pascalguttmann/fsd-amp/README.md

# fsd-amp

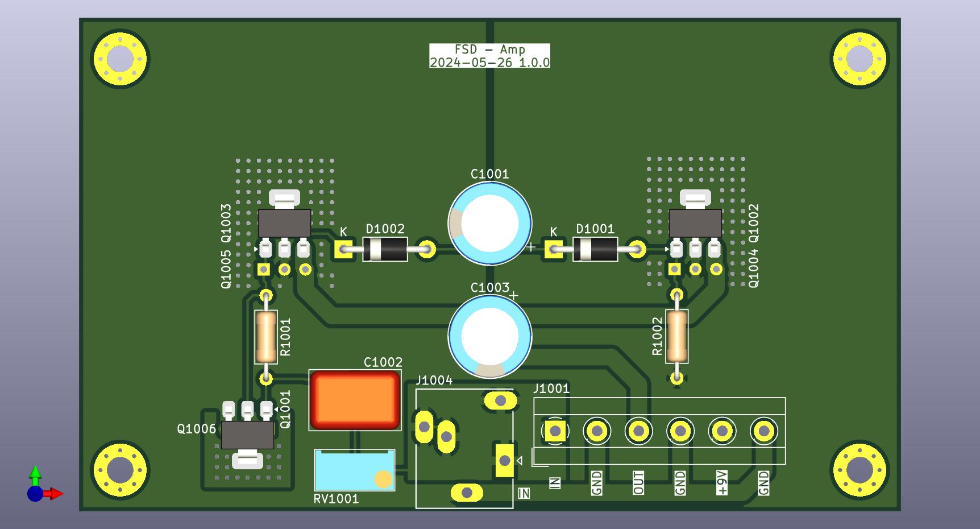
[picture p1: 3d-preview/fsd-amp.jpg]


Linear Audio Amplifier as demonstration for workshop at Freie Schule Dreisamtal.
PCB is used as a demonstrator for soldering excercises and fundamentals of circuit design.
