pascalguttmann/fsd-amp/bom/orders.xlsx

Sheet: 240527_order
n | 15
# | Qty / n | Total Qty | VPN | VLNK | Ordered
1 | 2 | 30 | RAD 470/16 | https://www.reichelt.de/elko-radial-470-f-16-v-rm-5-0-85-c-2000h-20--rad-470-16-p15148.html?trstct=pol_0&nbc=1 | x
2 | 1 | 15 | MKS2-50 10µ | https://www.reichelt.de/mks2-pet-kondensator-10-f-5-50-vdc-rm-5-mks2-50-10--p172683.html?trstct=pos_11&nbc=1 | x
3 | 2 | 30 | 1N 4001 | https://www.reichelt.de/gleichrichterdiode-50-v-1-a-do-41-1n-4001-p1723.html?&trstct=pos_0&nbc=1 | x
4 | 1 | 15 | AKL 101-06 | https://www.reichelt.de/anschlussklemme-6-pol-2-mm-rm-5-08-akl-101-06-p36609.html?search=AKL+101-06 | x
5 | 1 | 15 | EBS 35 | https://www.reichelt.de/klinkeneinbaubuchse-3-5-mm-stereo-ebs-35-p7301.html?&trstct=pol_4&nbc=1 | x
6 | 2 | 30 | FZT 653 ZET | https://www.reichelt.de/bipolartransistor-npn-100-v-2-a-2-w-sot-223-fzt-653-zet-p219138.html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 | x
7 | 1 | 15 | FZT 753 ZET | https://www.reichelt.de/bipolartransistor-pnp-100-v-2-a-2-w-sot-223-fzt-753-zet-p216608.html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 | x
8 | 3 | 45
9 | 1 | 15 | METALL 47,0K | https://www.reichelt.de/widerstand-metallschicht-47-0-kohm-0207-0-6-w-1--metall-47-0k-p11823.html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 | x
10 | 1 | 15 | METALL 150 | https://www.reichelt.de/widerstand-metallschicht-150-ohm-0207-0-6-w-1--metall-150-p11527.html | x
11 | 1 | 15 | 64W-20K | https://www.reichelt.de/praezisionspotentiometer-25-gaenge-stehend-20-kohm-64w-20k-p2705.html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 | x
12 | 1 | 15 | HDS LPAC010-005 |  | x

Sheet: fsd-amp_1 0 0
# | Reference | Value | VPN | Qty | VLNK | MPN | Do Not Place | Exclude from BOM | Exclude from Board | Exclude from Simulation | Footprint | Datasheet | Description
1 | C1001,C1003 | 470u | RAD 470/16 | 2 | https://www.reichelt.de/elko-radial-470-f-16-v-rm-5-0-85-c-2000h-20--rad-470-16-p15148.html?trstct=pol_0&nbc=1 |  |  |  |  |  | fp:CP_Radial_D10.0mm_P5.00mm | https://www.reichelt.de/elko-radial-470-f-16-v-rm-5-0-85-c-2000h-20--rad-470-16-p15148.html?trstct=pol_0&nbc=1 | Polarized capacitor
2 | C1002 | 10u | MKS2-50 10µ | 1 | https://www.reichelt.de/mks2-pet-kondensator-10-f-5-50-vdc-rm-5-mks2-50-10--p172683.html?trstct=pos_11&nbc=1 |  |  |  |  |  | fp:C_Rect_L7.2mm_W11.0mm_P5.00mm_FKS2_FKP2_MKS2_MKP2 | https://cdn-reichelt.de/documents/datenblatt/B300/WIMA_MKS_2.pdf | Unpolarized capacitor
3 | D1001,D1002 | 1N4001 | 1N 4001 | 2 | https://www.reichelt.de/gleichrichterdiode-50-v-1-a-do-41-1n-4001-p1723.html?&trstct=pos_0&nbc=1 |  |  |  |  |  | fp:D_DO-41_SOD81_P10.16mm_Horizontal | https://cdn-reichelt.de/documents/datenblatt/A400/1N4001-1N4007_LUNSURE.pdf | Diode
4 | J1001 | Screw_Terminal_01x06 | AKL 101-06 | 1 | https://www.reichelt.de/anschlussklemme-6-pol-2-mm-rm-5-08-akl-101-06-p36609.html?search=AKL+101-06 |  |  |  |  | Excluded from simulation | fp:TerminalBlock_MetzConnect_Type101_RT01606HBWC_1x06_P5.08mm_Horizontal | https://cdn-reichelt.de/documents/datenblatt/C100/AKL101%23RIA.pdf | Generic screw terminal, single row, 01x06, script generated (kicad-library-utils/schlib/autogen/connector/)
5 | J1004 | AudioJack2_Ground_Switch | EBS 35 | 1 | https://www.reichelt.de/klinkeneinbaubuchse-3-5-mm-stereo-ebs-35-p7301.html?&trstct=pol_4&nbc=1 |  |  |  |  | Excluded from simulation | fp:Jack_3.5mm_Ledino_KB3SPRS_Horizontal | https://cdn-reichelt.de/documents/datenblatt/C160/KB3SPRS.pdf | Audio Jack, 2 Poles (Mono / TS), Grounded Sleeve, Switched Pole (Normalling)
6 | Q1001,Q1002 | FZT 653 ZET | FZT 653 ZET | 2 | https://www.reichelt.de/bipolartransistor-npn-100-v-2-a-2-w-sot-223-fzt-653-zet-p219138.html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 |  |  |  |  |  | fp:SOT-223-3_TabPin2 | https://cdn-reichelt.de/documents/datenblatt/A100/FZT653.pdf | NPN transistor, base/collector/emitter
7 | Q1003 | FZT 753 ZET | FZT 753 ZET | 1 | https://www.reichelt.de/bipolartransistor-pnp-100-v-2-a-2-w-sot-223-fzt-753-zet-p216608.html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 |  |  |  |  |  | fp:SOT-223-3_TabPin2 | https://cdn-reichelt.de/documents/datenblatt/A100/FZT753.pdf | PNP transistor, base/collector/emitter
8 | Q1004,Q1005,Q1006 | -- mixed values -- |  | 3 |  |  | DNP |  |  | Excluded from simulation | fp:TO-92_Inline_Wide_NOcourtyard | ~ | -- mixed values --
9 | R1001 | 47k | METALL 47,0K | 1 | https://www.reichelt.de/widerstand-metallschicht-47-0-kohm-0207-0-6-w-1--metall-47-0k-p11823.html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 |  |  |  |  |  | fp:R_Axial_DIN0207_L6.3mm_D2.5mm_P10.16mm_Horizontal | https://cdn-reichelt.de/documents/datenblatt/B400/METALL%23YAG.pdf | Resistor
10 | R1002 | 150 | METALL 150 | 1 | https://www.reichelt.de/widerstand-metallschicht-150-ohm-0207-0-6-w-1--metall-150-p11527.html |  |  |  |  |  | fp:R_Axial_DIN0207_L6.3mm_D2.5mm_P10.16mm_Horizontal | https://cdn-reichelt.de/documents/datenblatt/B400/METALL%23YAG.pdf | Resistor
11 | RV1001 | 20k | 64W-20K | 1 | https://www.reichelt.de/praezisionspotentiometer-25-gaenge-stehend-20-kohm-64w-20k-p2705.html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 |  |  |  |  |  | fp:Potentiometer_Bourns_3296W_Vertical | https://www.reichelt.de/praezisionspotentiometer-25-gaenge-stehend-20-kohm-64w-20k-p2705.html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 | Potentiometer
