pascalguttmann/fsd-amp/pdf/240609_fsd-amp_schematic_1.0.1.pdf

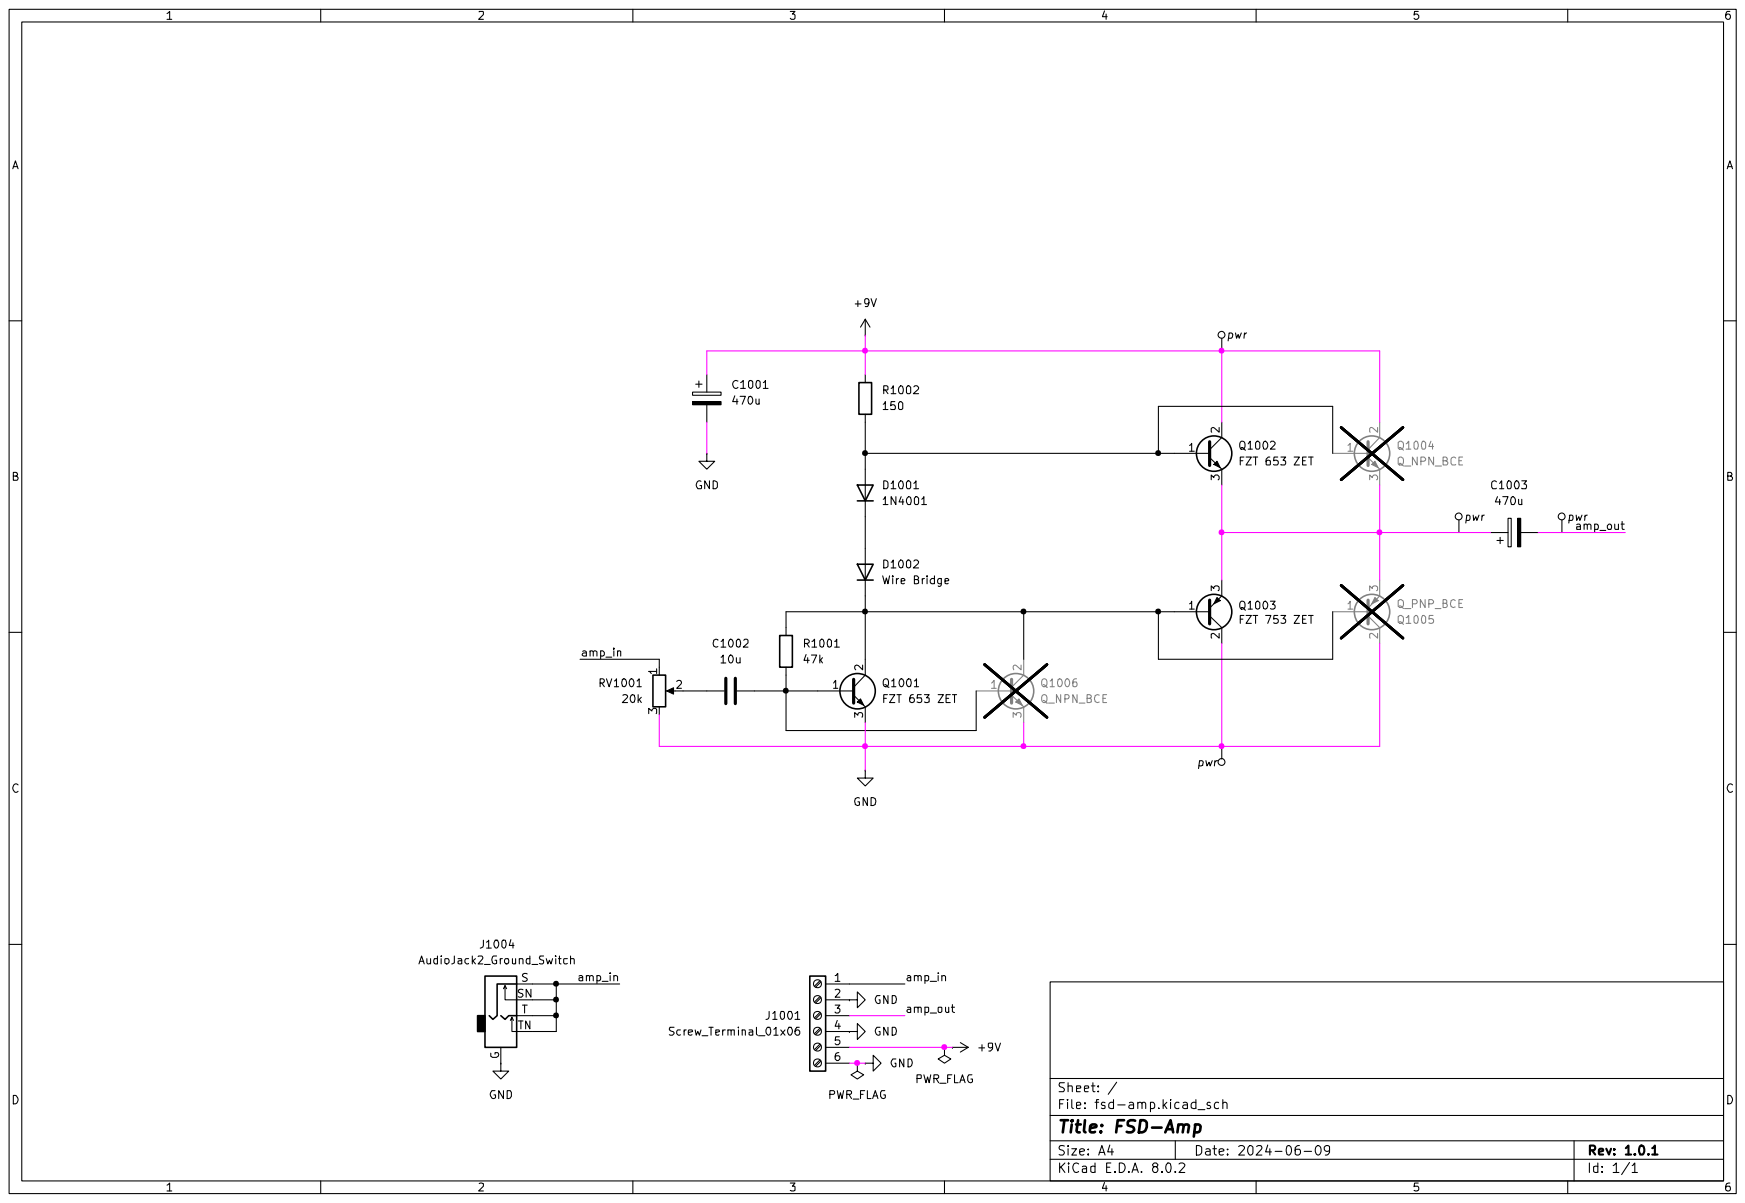
[picture p2: page 1]
