pascalguttmann/fsd-amp/fsd-amp.kicad_pcb

## KiCad design fsd-amp.kicad_pcb (2024-06-08)

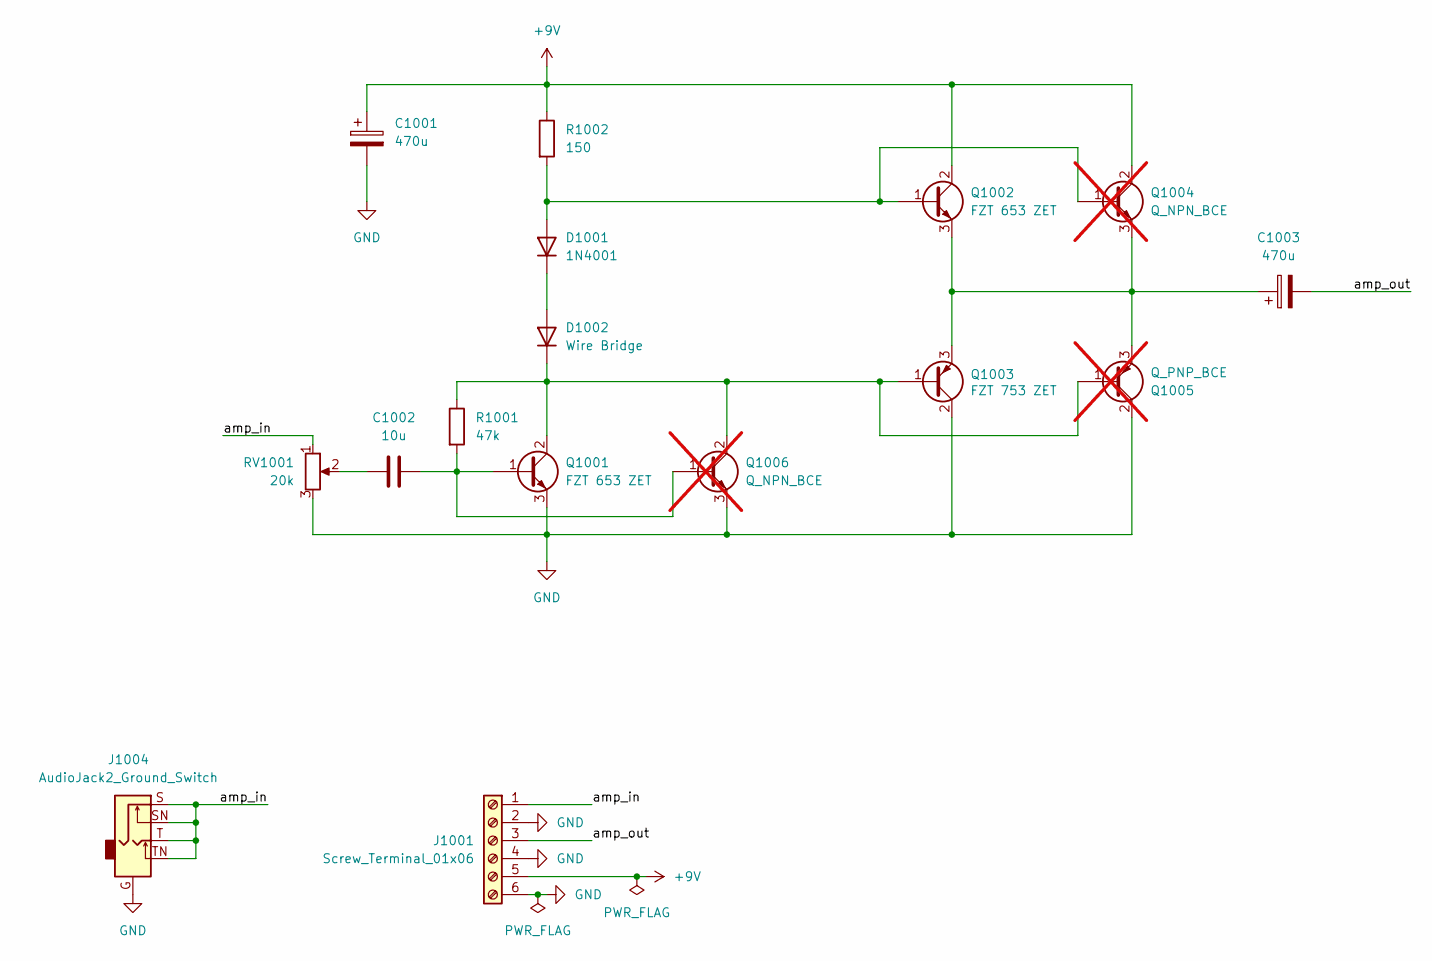
[picture p3: schematic fsd-amp.kicad_sch]

Parts:
C1001, C1003: 470u; CP_Radial_D10.0mm_P5.00mm
C1002: 10u; C_Rect_L7.2mm_W11.0mm_P5.00mm_FKS2_FKP2_MKS2_MKP2
D1001: 1N4001; D_DO-41_SOD81_P10.16mm_Horizontal
D1002: Wire Bridge; D_DO-41_SOD81_P10.16mm_Horizontal
J1001: Screw_Terminal_01x06; TerminalBlock_MetzConnect_Type101_RT01606HBWC_1x06_P5.08mm_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
J1004: AudioJack2_Ground_Switch; Jack_3.5mm_Ledino_KB3SPRS_Horizontal
Q1001, Q1002: FZT 653 ZET; SOT-223-3_TabPin2
Q1003: FZT 753 ZET; SOT-223-3_TabPin2
Q1004, Q1006: Q_NPN_BCE; TO-92_Inline_Wide_NOcourtyard; not fitted
Q1005: Q_PNP_BCE; TO-92_Inline_Wide_NOcourtyard; not fitted
R1001: 47k; R_Axial_DIN0207_L6.3mm_D2.5mm_P10.16mm_Horizontal
R1002: 150; R_Axial_DIN0207_L6.3mm_D2.5mm_P10.16mm_Horizontal
RV1001: 20k; Potentiometer_Bourns_3296W_Vertical

Connections:
+9V: C1001.1, J1001.5, Q1002.2 (C), Q1004.2 (C), R1002.1
/amp_in: J1001.1, J1004.S, J1004.SN, J1004.T, J1004.TN, RV1001.1
/amp_out: C1003.2, J1001.3
GND: C1001.2, J1001.2, J1001.4, J1001.6, J1004.G, Q1001.3 (E), Q1003.2 (C), Q1005.2 (C), Q1006.3 (E), RV1001.3
unnamed: C1002.1, RV1001.2
unnamed: D1001.2 (A), Q1002.1 (B), Q1004.1 (B), R1002.2
unnamed: D1001.1 (K), D1002.2 (A)
unnamed: D1002.1 (K), Q1001.2 (C), Q1003.1 (B), Q1005.1 (B), Q1006.2 (C), R1001.1
unnamed: C1002.2, Q1001.1 (B), Q1006.1 (B), R1001.2
unnamed: C1003.1, Q1002.3 (E), Q1003.3 (E), Q1004.3 (E), Q1005.3 (E)

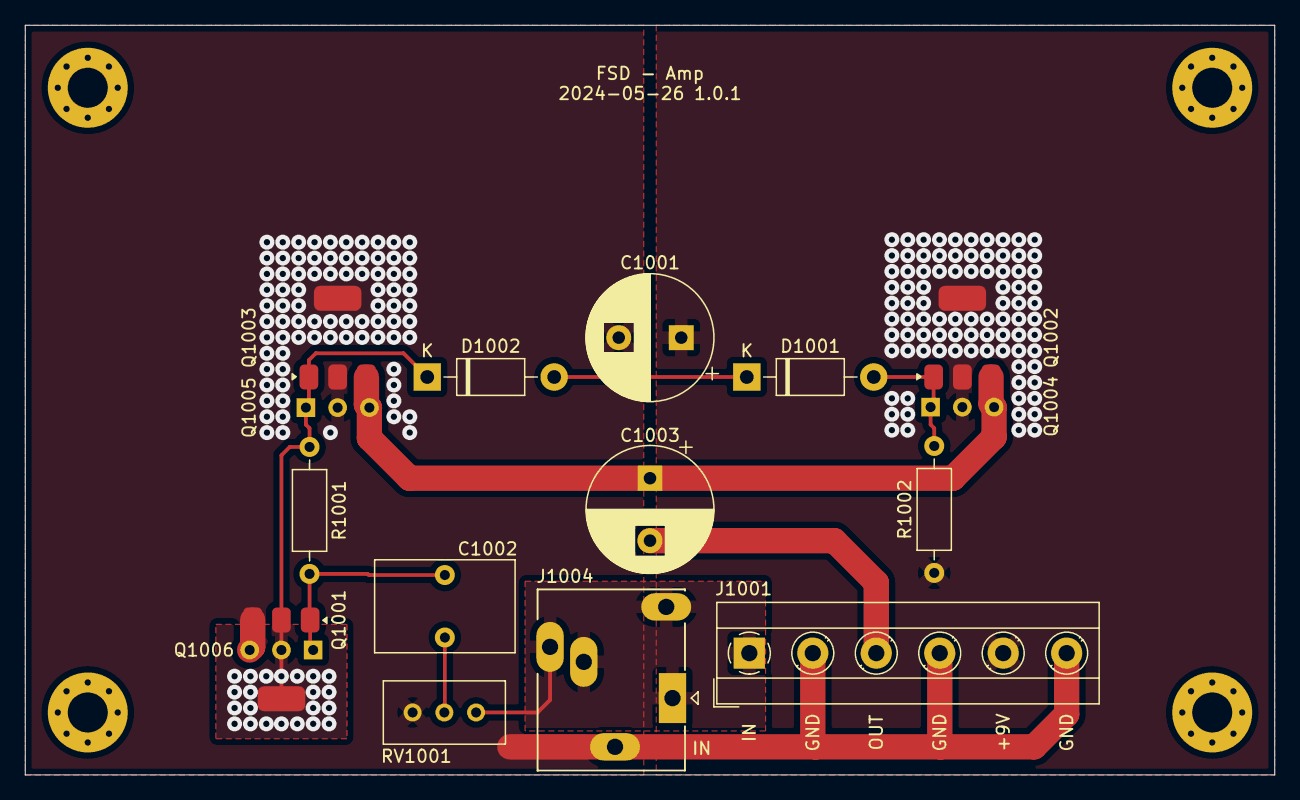
[picture p4: board fsd-amp.kicad_pcb from above]

Board: 2 copper layers, 100.0 x 60.0 mm, 16 parts (0 on the bottom side), 10 nets.
