pascalguttmann/fsd-amp/(commit log)

2024-05-24 add KiCad project
    [fsd-amp.kicad_pcb, fsd-amp.kicad_sch]
2024-05-24 add schematic labels and settings
    [fsd-amp.kicad_sch]
2024-05-24 add schematic
    [fsd-amp.kicad_sch]
2024-05-24 add parts from reichelt
    [fsd-amp.kicad_sch]
2024-05-24 add poti for volume adjustment
    [fsd-amp.kicad_sch]
2024-05-24 fix ERC pwr_flag error
    [fsd-amp.kicad_sch]
2024-05-24 add footprints
    [fsd-amp.kicad_pcb, fsd-amp.kicad_sch]
2024-05-24 export footprints and symbols to project libraries
    [fsd-amp.kicad_pcb, fsd-amp.kicad_sch]
2024-05-24 add pcb DRU, Standard Sizes and Netclasses
    [fsd-amp.kicad_pcb, fsd-amp.kicad_sch]
2024-05-24 define edge cuts board outline
    [fsd-amp.kicad_pcb]
2024-05-24 coarse placement of footprints
    [fsd-amp.kicad_pcb]
2024-05-26 fix placement of power bjt
    [fsd-amp.kicad_pcb]
2024-05-26 add routing
    [fsd-amp.kicad_pcb]
2024-05-26 widen thermal relief spokes
    [fsd-amp.kicad_pcb]
2024-05-26 add netclass colorization
    [fsd-amp.kicad_sch]
2024-05-26 add fill zone bottom side
    [fsd-amp.kicad_pcb]
2024-05-26 add thermal relief for transistors
    [fsd-amp.kicad_pcb]
2024-05-26 fix drc errors
    [fsd-amp.kicad_pcb]
2024-05-26 fix drc warnings, enhace silkscreen
    - fix drc warnings (silk screen related)
    - move mounting holes to 'fp' library
    - enhance silkscreen placement
    - remove outline silkscreen from SOT-223 footprint
    - remove silkscreen out of board from audion jack
    [fsd-amp.kicad_pcb]
2024-05-26 add backup THT transistor footprint
    [fsd-amp.kicad_pcb, fsd-amp.kicad_sch]
2024-05-26 add connection labels on silkT
    [fsd-amp.kicad_pcb]
2024-05-26 add title at f.silk
    [fsd-amp.kicad_pcb]
2024-05-26 add fp library with TO-92 footprints
2024-05-26 add variable substitution for date and revision
    [fsd-amp.kicad_pcb]
2024-05-26 fix small trace in plane, creating spoke at pads
    [fsd-amp.kicad_pcb]
2024-05-27 add order 240527
    - bom export
    - excel order overview
    - ungitignore bom export
    [fsd-amp_1.0.0.csv, orders.xlsx]
2024-06-08 pcb auto rotate of components 360 deg
    [fsd-amp.kicad_pcb]
2024-06-08 add schematic version to ibom name
2024-06-08 fix excess quiescent current
    - bias voltage is to high resulting in excess current flow of approx 1A in the complementary emitter follower
    - replace D1002 from diode to wire bridge to reduce the bias voltage
    ´
    [fsd-amp.kicad_pcb, fsd-amp.kicad_sch]
2024-06-08 bump patch version of schematic
    - add ibom for sch1.0.1
    - add schematic 1.0.1
